j-marjanovic/theremin/PIC/ADC_ctrls.X/docs/README.txt

///////////////////////////////////////////////////////////////////////////////
//   __  __          _____      _         _   _  ______      _______ _____   //
//  |  \/  |   /\   |  __ \    | |  /\   | \ | |/ __ \ \    / /_   _/ ____|  //
//  | \  / |  /  \  | |__) |   | | /  \  |  \| | |  | \ \  / /  | || |       //
//  | |\/| | / /\ \ |  _  /_   | |/ /\ \ | . ` | |  | |\ \/ /   | || |       //
//  | |  | |/ ____ \| | \ \ |__| / ____ \| |\  | |__| | \  /   _| || |____   //
//  |_|  |_/_/    \_\_|  \_\____/_/    \_\_| \_|\____/   \/   |_____\_____|  //
//                                                                           //
//                          JAN MARJANOVIC, 2014                             //
//                                                                           //
///////////////////////////////////////////////////////////////////////////////

                            Analog inputs for FPGA

This Microchip PIC16F88 converts analog inputs and transmits data via UART
to FPGA.

UART is at 9600 bps.

Produced output:
MEAS:d5:a3:cf:02:33:00:f7:\r\n
