j-marjanovic/theremin/meas/antenna_2/theremin_freq_05cm.png

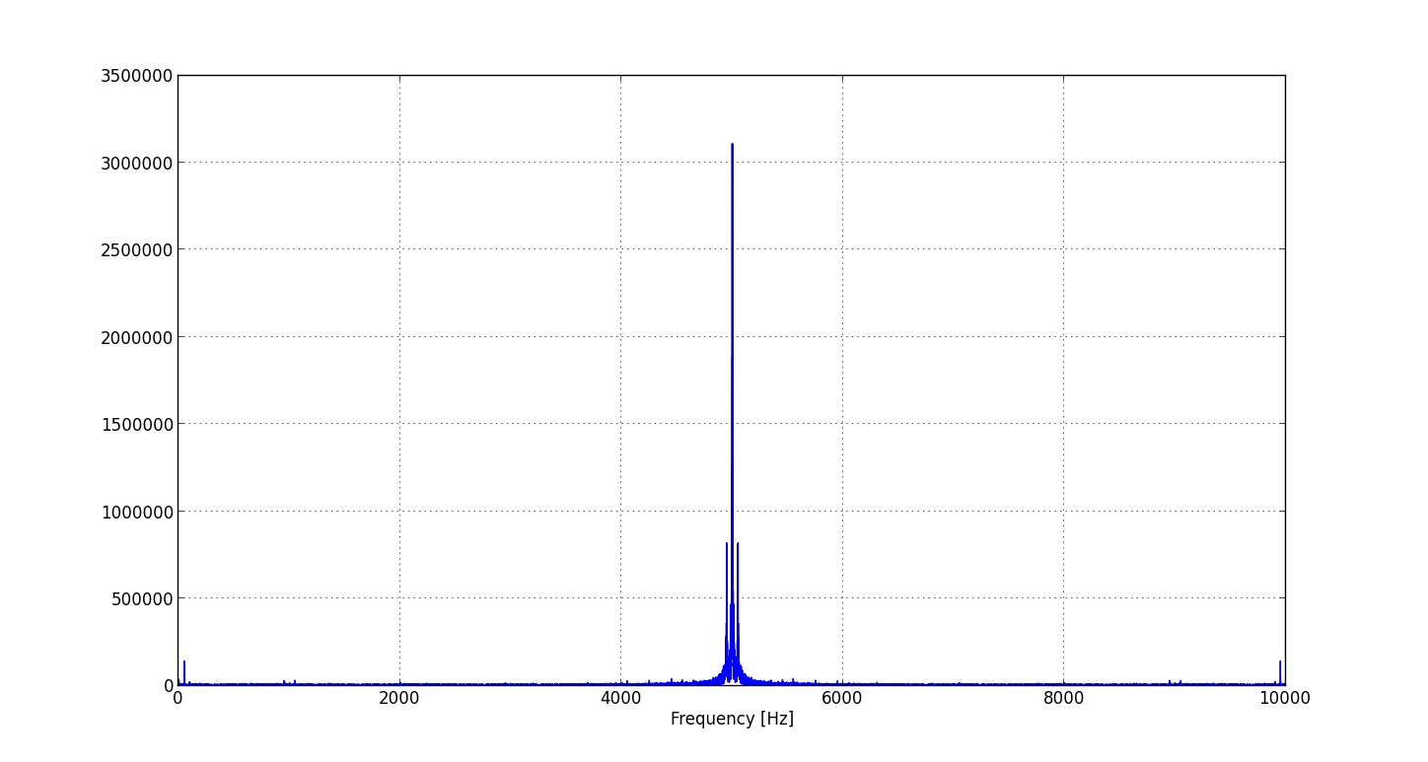
meas/antenna_2/theremin_freq_05cm.png
