j-marjanovic/theremin/meas/antenna_2/theremin_meas.png

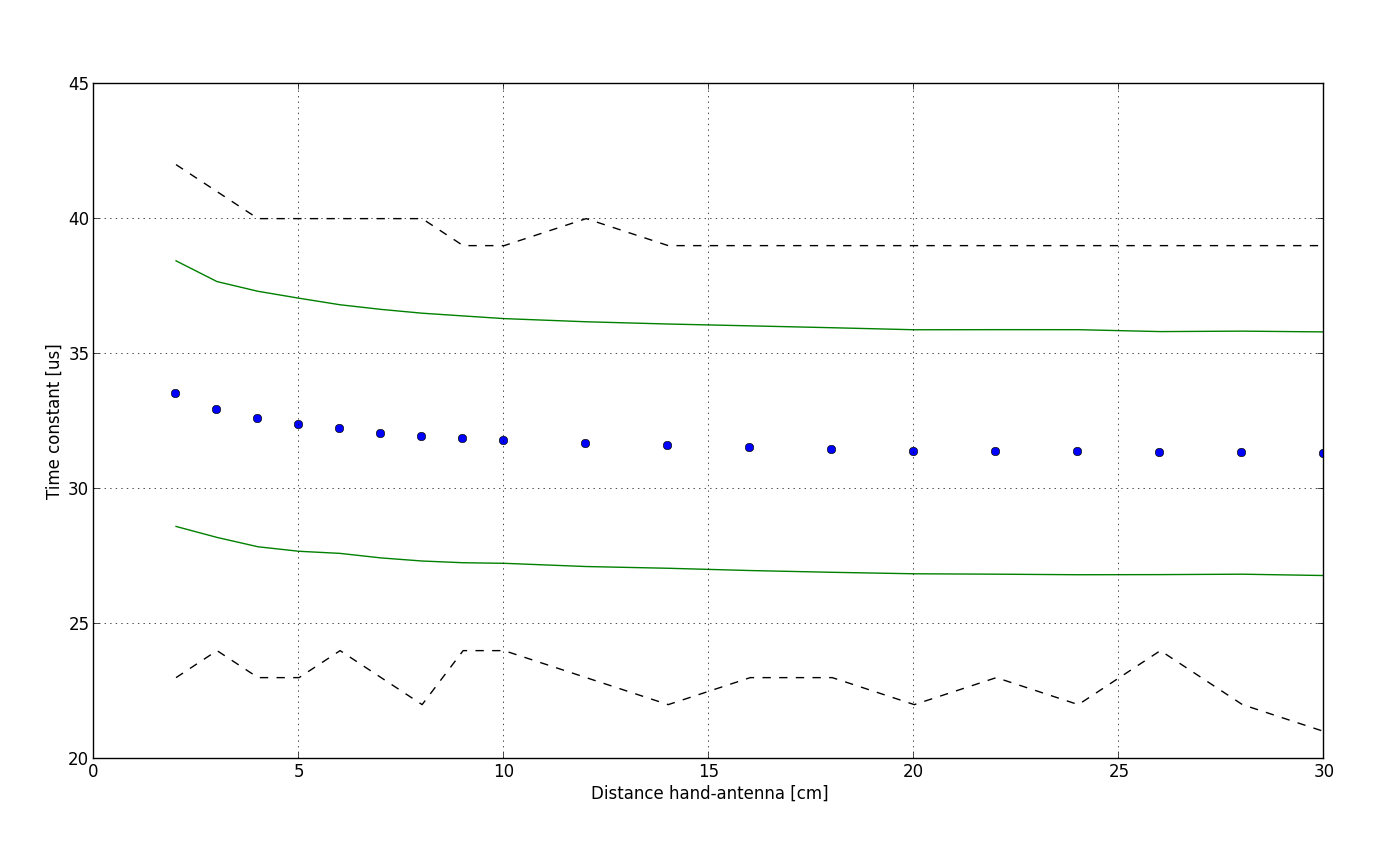
meas/antenna_2/theremin_meas.png
