j-marjanovic/theremin/meas/antenna_2/theremin_meas_mean.png

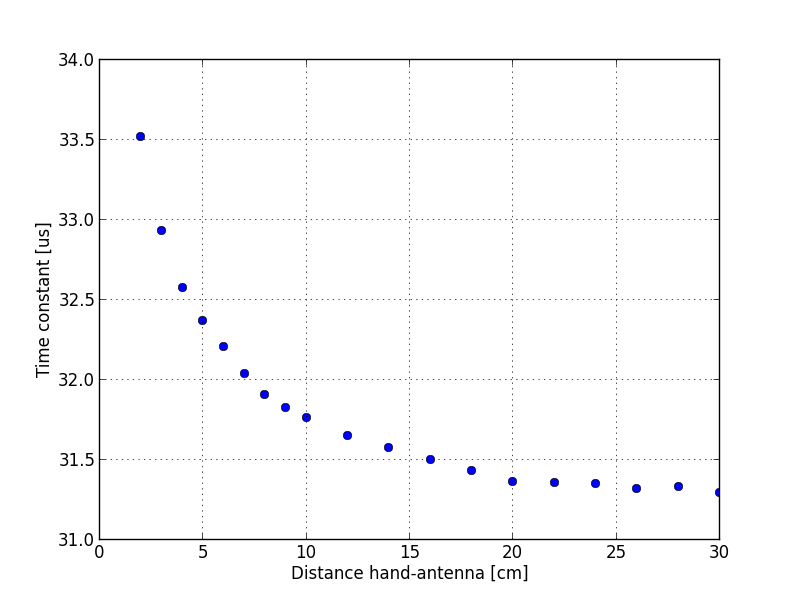
meas/antenna_2/theremin_meas_mean.png
