j-marjanovic/theremin/meas/filter_avg/tc_after_filter.png

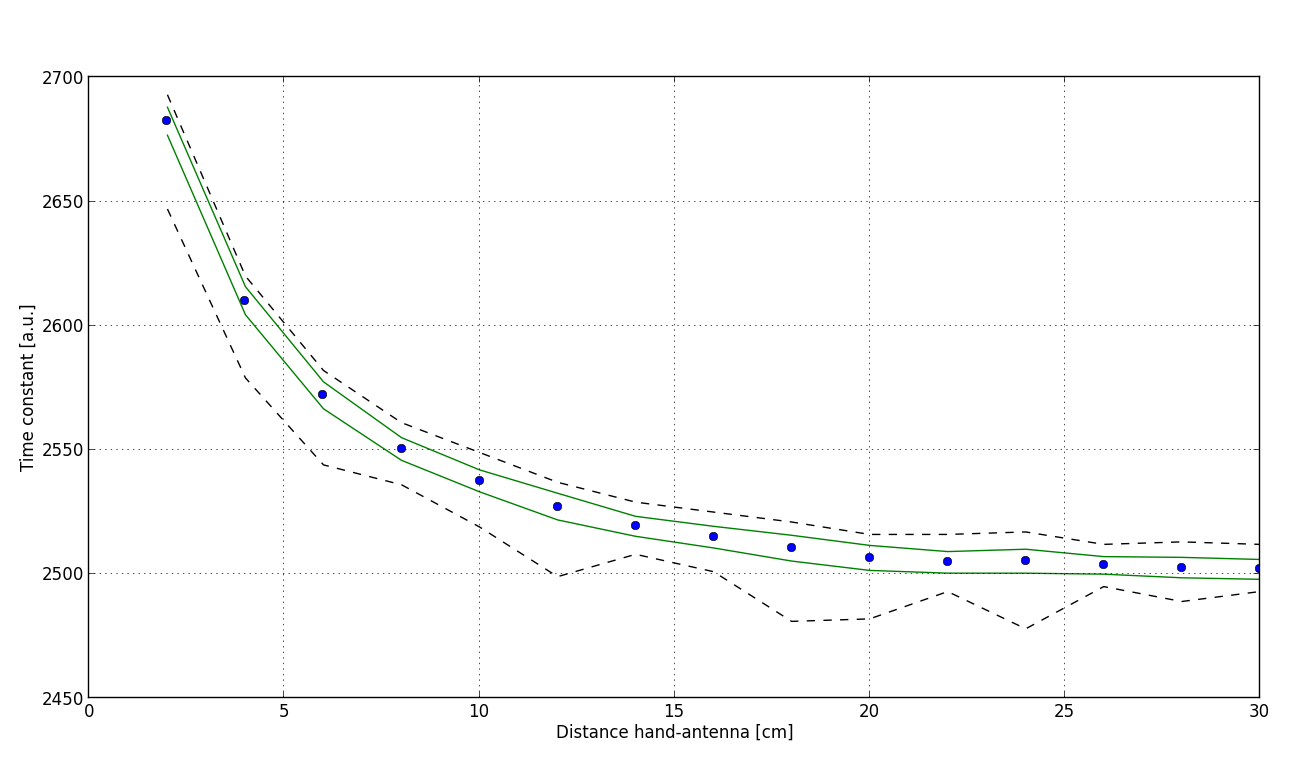
meas/filter_avg/tc_after_filter.png
