j-marjanovic/theremin/docs/components.txt

R8 = 10k
R9 = 10k
R10 = 10k
R13 = 100
R14 = 100

-10dBV = 0.316 volts AC
+4dBu = 1.23 volts AC

(R11 || R12)/R10 = 0.316V/3.3V = 0.09575

R11/R10 = 1.23V/3.3V = 0.372 --> R1 = 3.3k

R11 || R12 = 957

alternativa: 
R10 = 47k
R11 = 0.372*R10 = 18k
R11 || R12 = 4.5k
R12 = 5.6k
