j-marjanovic/theremin/(list of files, cad)

Other CAD files:
FPGA/signal_taps/delay.stp
FPGA/signal_taps/PIC_CTRL_in.stp
FPGA/signal_taps/TC.stp
FPGA/signal_taps/antenna.stp
FPGA/signal_taps/DAC.stp
