j-marjanovic/theremin/schematics/theremin_PCB.brd

## EAGLE design schematics/theremin_PCB.brd (2014-09-25)

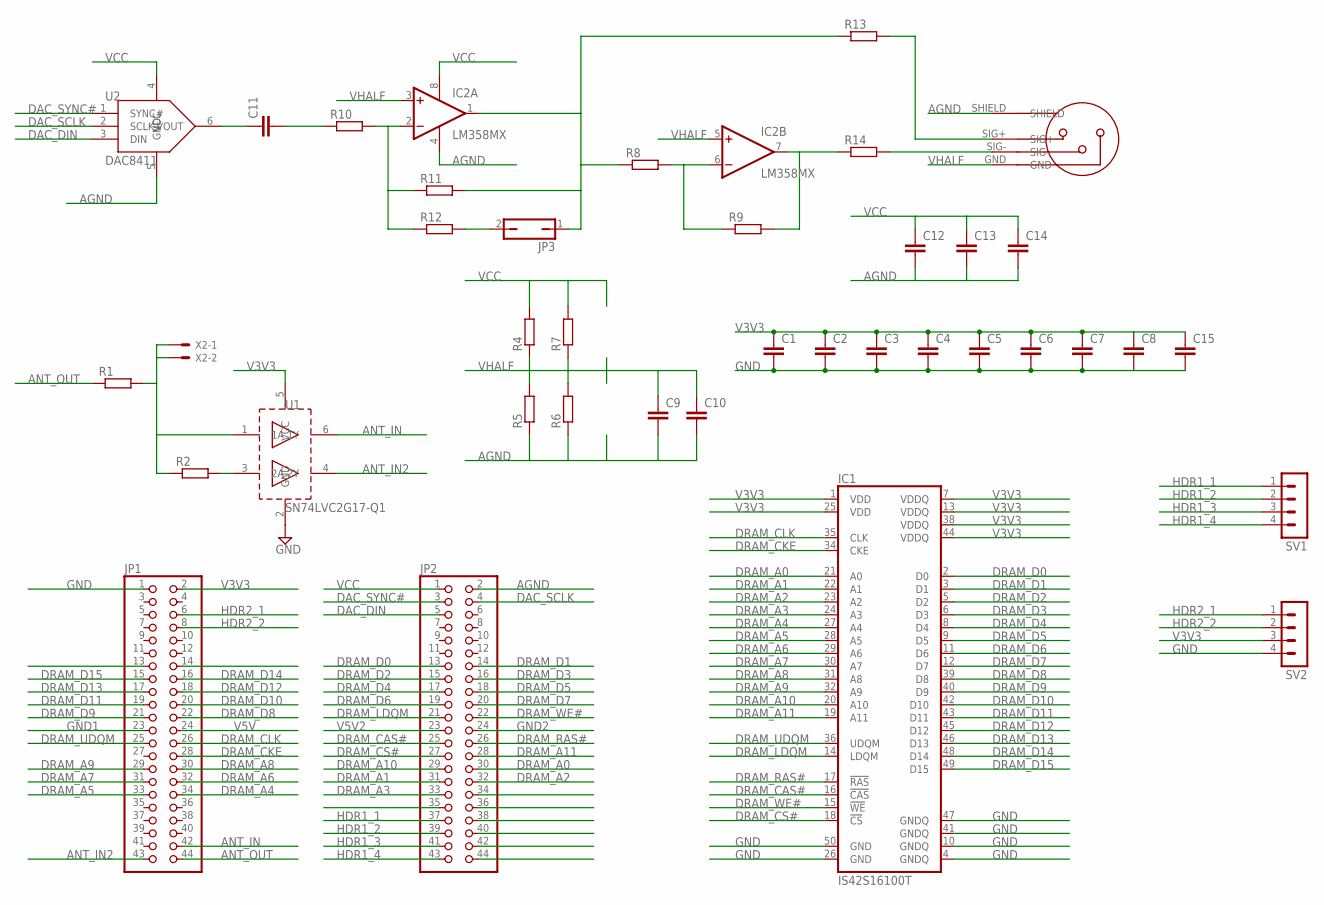
[picture p5: schematic theremin_PCB.sch]

Parts:
C1, C2, C3, C4, C5, C6, C7, C8, C9, C10, C11, C12, C13, C14, C15: C-EUC0805; C0805
IC1: IS42S16100T; TSOP50-II
IC2: LM358MX; SO08
JP1, JP2: PINHD-2X22; 2X22
JP3: JP1Q; JP1
R1, R2: R-EU_R0603; R0603
R4, R5, R6, R7, R8, R9, R10, R11, R12, R13, R14: R-EU_M0805; M0805
SV1, SV2: MA04-1
U1: SN74LVC2G17-Q1; DCK_R-PDSO-G6
U2: DAC8411; DCK_R-PDSO-G6
U$1: MINIXLR; MINXLR
X2: KK-156-2

Connections:
AGND: C9.2, C10.2, C12.2, C13.2, C14.2, IC2.4 (V-), JP2.2, R5.1, R6.1, U2.5 (GND), U$1.SHIELD
ANT_IN: JP1.42, U1.6 (1Y)
ANT_IN2: JP1.43, U1.4 (2Y)
ANT_OUT: JP1.44, R1.1
DAC_DIN: JP2.5, U2.3 (DIN)
DAC_SCLK: JP2.4, U2.2 (SCLK)
DAC_SYNC#: JP2.3, U2.1 (SYNC#)
DRAM_A0: IC1.21 (A0), JP2.30
DRAM_A1: IC1.22 (A1), JP2.31
DRAM_A2: IC1.23 (A2), JP2.32
DRAM_A3: IC1.24 (A3), JP2.33
DRAM_A4: IC1.27 (A4), JP1.34
DRAM_A5: IC1.28 (A5), JP1.33
DRAM_A6: IC1.29 (A6), JP1.32
DRAM_A7: IC1.30 (A7), JP1.31
DRAM_A8: IC1.31 (A8), JP1.30
DRAM_A9: IC1.32 (A9), JP1.29
DRAM_A10: IC1.20 (A10), JP2.29
DRAM_A11: IC1.19 (A11), JP2.28
DRAM_CAS#: IC1.16 (!CAS), JP2.25
DRAM_CKE: IC1.34 (CKE), JP1.28
DRAM_CLK: IC1.35 (CLK), JP1.26
DRAM_CS#: IC1.18 (!CS), JP2.27
DRAM_D0: IC1.2 (D0), JP2.13
DRAM_D1: IC1.3 (D1), JP2.14
DRAM_D2: IC1.5 (D2), JP2.15
DRAM_D3: IC1.6 (D3), JP2.16
DRAM_D4: IC1.8 (D4), JP2.17
DRAM_D5: IC1.9 (D5), JP2.18
DRAM_D6: IC1.11 (D6), JP2.19
DRAM_D7: IC1.12 (D7), JP2.20
DRAM_D8: IC1.39 (D8), JP1.22
DRAM_D9: IC1.40 (D9), JP1.21
DRAM_D10: IC1.42 (D10), JP1.20
DRAM_D11: IC1.43 (D11), JP1.19
DRAM_D12: IC1.45 (D12), JP1.18
DRAM_D13: IC1.46 (D13), JP1.17
DRAM_D14: IC1.48 (D14), JP1.16
DRAM_D15: IC1.49 (D15), JP1.15
DRAM_LDQM: IC1.14 (LDQM), JP2.21
DRAM_RAS#: IC1.17 (!RAS), JP2.26
DRAM_UDQM: IC1.36 (UDQM), JP1.25
DRAM_WE#: IC1.15 (!WE), JP2.22
GND: C1.2, C2.2, C3.2, C4.2, C5.2, C6.2, C7.2, C8.2, C15.2, IC1.4 (GNDQ), IC1.10 (GNDQ), IC1.26 (GND), IC1.41 (GNDQ), IC1.47 (GNDQ), IC1.50 (GND), JP1.1, SV2.4, U1.2 (GND)
GND1: JP1.23
GND2: JP2.24
HDR1_1: JP2.37, SV1.1
HDR1_2: JP2.39, SV1.2
HDR1_3: JP2.41, SV1.3
HDR1_4: JP2.43, SV1.4
HDR2_1: JP1.6, SV2.1
HDR2_2: JP1.8, SV2.2
unnamed: R1.2, R2.1, U1.1 (1A), X2.1, X2.2
unnamed: C11.1, U2.6 (VOUT)
unnamed: C11.2, R10.1
unnamed: R2.2, U1.3 (2A)
unnamed: IC2.2 (-IN), R10.2, R11.1, R12.1
unnamed: JP3.2, R12.2
unnamed: IC2.1 (OUT), JP3.1, R8.1, R11.2, R13.1
unnamed: R14.2, U$1.SIG-
unnamed: IC2.6 (-IN), R8.2, R9.1
unnamed: IC2.7 (OUT), R9.2, R14.1
unnamed: R13.2, U$1.SIG+
V3V3: C1.1, C2.1, C3.1, C4.1, C5.1, C6.1, C7.1, C8.1, C15.1, IC1.1 (VDD), IC1.7 (VDDQ), IC1.13 (VDDQ), IC1.25 (VDD), IC1.38 (VDDQ), IC1.44 (VDDQ), JP1.2, SV2.3, U1.5 (VCC)
V5V: JP1.24
V5V2: JP2.23
VCC: C12.1, C13.1, C14.1, IC2.8 (V+), JP2.1, R4.2, R7.2, U2.4 (VCC)
VHALF: C9.1, C10.1, IC2.3 (+IN), IC2.5 (+IN), R4.1, R5.2, R6.2, R7.1, U$1.GND

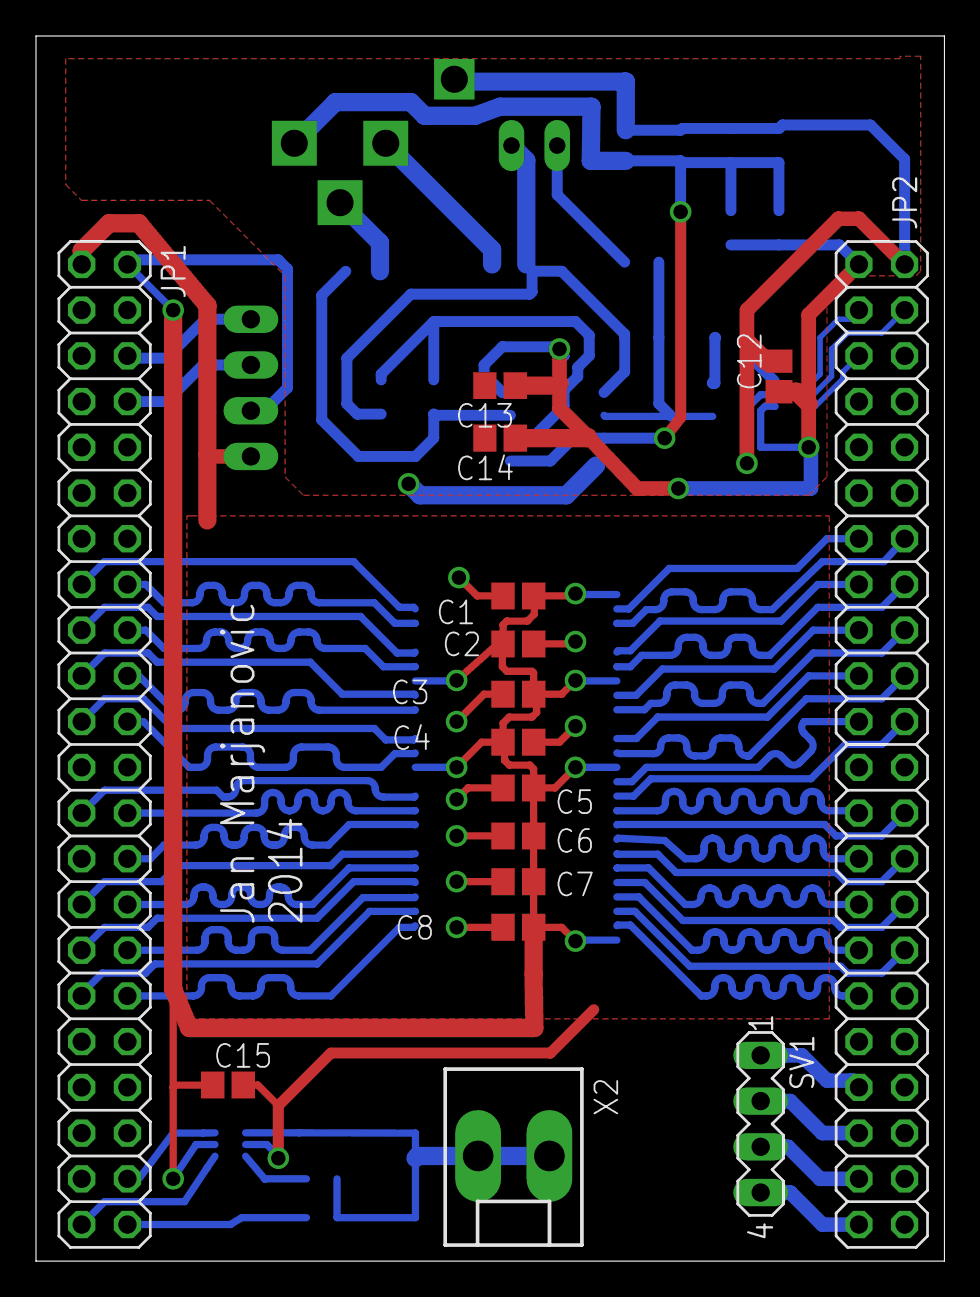
[picture p6: board theremin_PCB.brd from above]

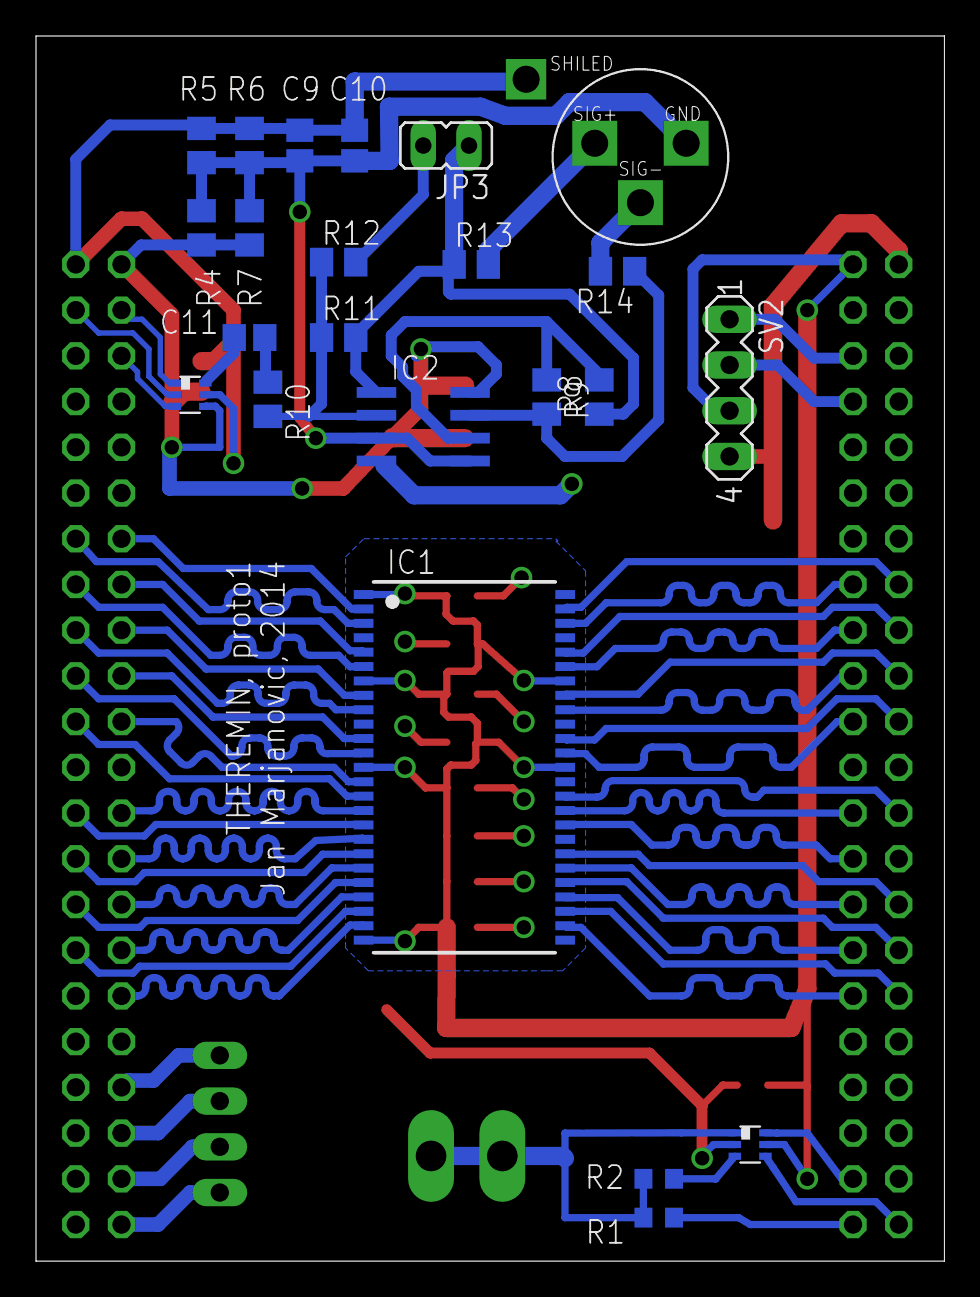
[picture p7: board theremin_PCB.brd from below]

Board: 2 copper layers, 50.5 x 68.1 mm, 39 parts (23 on the bottom side), 64 nets.
