j-marjanovic/theremin/PIC/ADC_ctrls.X/main.c

/******************************************************************************/
/* Files to Include                                                           */
/******************************************************************************/

#if defined(__XC)
    #include <xc.h>         /* XC8 General Include File */
#elif defined(HI_TECH_C)
    #include <htc.h>        /* HiTech General Include File */
#endif

#include <stdint.h>        /* For uint8_t definition */
#include <stdbool.h>       /* For true/false definition */

#include "system.h"        /* System funct/params, like osc/peripheral config */
#include "user.h"          /* User funct/params, such as InitApp */

/******************************************************************************/
/* User Global Variable Declaration                                           */
/******************************************************************************/

uint8_t ADCvalue[ADC_CHNS];
char str[64];


/******************************************************************************/
/* Main Program                                                               */
/******************************************************************************/
void main(void)
{
    /* Configure the oscillator for the device */
    ConfigureOscillator();

    /* Initialize I/O and Peripherals for application */
    InitApp();



    while(1)
    {
        doMeas(ADCvalue);
        createMeasString(str, ADCvalue);
        UART_Send_String(str);

        __delay_ms(1); //Delay
    }

}
