j-marjanovic/theremin/filter_50Hz/signal.h

signal[0] = 16'd3559;
signal[1] = 16'd2803;
signal[2] = 16'd3721;
signal[3] = 16'd2935;
signal[4] = 16'd3635;
signal[5] = 16'd2886;
signal[6] = 16'd3145;
signal[7] = 16'd2696;
signal[8] = 16'd3327;
signal[9] = 16'd2769;
signal[10] = 16'd3669;
signal[11] = 16'd2882;
signal[12] = 16'd3734;
signal[13] = 16'd2867;
signal[14] = 16'd3739;
signal[15] = 16'd2883;
signal[16] = 16'd3724;
signal[17] = 16'd2840;
signal[18] = 16'd3716;
signal[19] = 16'd2820;
signal[20] = 16'd3779;
signal[21] = 16'd2830;
signal[22] = 16'd3809;
signal[23] = 16'd2815;
signal[24] = 16'd3842;
signal[25] = 16'd2771;
signal[26] = 16'd3848;
signal[27] = 16'd2736;
signal[28] = 16'd3767;
signal[29] = 16'd2648;
signal[30] = 16'd3899;
signal[31] = 16'd2740;
signal[32] = 16'd3894;
signal[33] = 16'd2755;
signal[34] = 16'd3906;
signal[35] = 16'd2741;
signal[36] = 16'd3887;
signal[37] = 16'd2732;
signal[38] = 16'd3921;
signal[39] = 16'd2677;
signal[40] = 16'd3950;
signal[41] = 16'd2706;
signal[42] = 16'd3971;
signal[43] = 16'd2662;
signal[44] = 16'd3957;
signal[45] = 16'd2704;
signal[46] = 16'd3899;
signal[47] = 16'd2632;
signal[48] = 16'd3975;
signal[49] = 16'd2656;
signal[50] = 16'd3984;
signal[51] = 16'd2670;
signal[52] = 16'd3985;
signal[53] = 16'd2654;
signal[54] = 16'd3979;
signal[55] = 16'd2674;
signal[56] = 16'd3974;
signal[57] = 16'd2674;
signal[58] = 16'd3965;
signal[59] = 16'd2672;
signal[60] = 16'd3942;
signal[61] = 16'd2624;
signal[62] = 16'd3972;
signal[63] = 16'd2691;
signal[64] = 16'd4002;
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
signal[4832] = 16'd2682;
signal[4833] = 16'd3960;
signal[4834] = 16'd2714;
signal[4835] = 16'd3999;
signal[4836] = 16'd2641;
signal[4837] = 16'd3992;
signal[4838] = 16'd2640;
signal[4839] = 16'd4000;
signal[4840] = 16'd2615;
signal[4841] = 16'd4002;
signal[4842] = 16'd2686;
signal[4843] = 16'd4002;
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
