j-marjanovic/theremin/FPGA/src/LUT_sin.sv

initial begin
    LUT_sin[0] = 16'd32768;
    LUT_sin[1] = 16'd33170;
    LUT_sin[2] = 16'd33572;
    LUT_sin[3] = 16'd33974;
    LUT_sin[4] = 16'd34375;
    LUT_sin[5] = 16'd34777;
    LUT_sin[6] = 16'd35178;
    LUT_sin[7] = 16'd35579;
    LUT_sin[8] = 16'd35979;
    LUT_sin[9] = 16'd36379;
    LUT_sin[10] = 16'd36779;
    LUT_sin[11] = 16'd37177;
    LUT_sin[12] = 16'd37575;
    LUT_sin[13] = 16'd37973;
    LUT_sin[14] = 16'd38369;
    LUT_sin[15] = 16'd38765;
    LUT_sin[16] = 16'd39160;
    LUT_sin[17] = 16'd39554;
    LUT_sin[18] = 16'd39947;
    LUT_sin[19] = 16'd40339;
    LUT_sin[20] = 16'd40729;
    LUT_sin[21] = 16'd41119;
    LUT_sin[22] = 16'd41507;
    LUT_sin[23] = 16'd41894;
    LUT_sin[24] = 16'd42279;
    LUT_sin[25] = 16'd42663;
    LUT_sin[26] = 16'd43046;
    LUT_sin[27] = 16'd43427;
    LUT_sin[28] = 16'd43806;
    LUT_sin[29] = 16'd44184;
    LUT_sin[30] = 16'd44560;
    LUT_sin[31] = 16'd44934;
    LUT_sin[32] = 16'd45307;
    LUT_sin[33] = 16'd45677;
    LUT_sin[34] = 16'd46046;
    LUT_sin[35] = 16'd46413;
    LUT_sin[36] = 16'd46777;
    LUT_sin[37] = 16'd47140;
    LUT_sin[38] = 16'd47500;
    LUT_sin[39] = 16'd47858;
    LUT_sin[40] = 16'd48214;
    LUT_sin[41] = 16'd48567;
    LUT_sin[42] = 16'd48918;
    LUT_sin[43] = 16'd49267;
    LUT_sin[44] = 16'd49613;
    LUT_sin[45] = 16'd49957;
    LUT_sin[46] = 16'd50298;
    LUT_sin[47] = 16'd50636;
    LUT_sin[48] = 16'd50972;
    LUT_sin[49] = 16'd51305;
    LUT_sin[50] = 16'd51635;
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
    LUT_sin[499] = 16'd27562;
    LUT_sin[500] = 16'd27960;
    LUT_sin[501] = 16'd28358;
    LUT_sin[502] = 16'd28756;
    LUT_sin[503] = 16'd29156;
    LUT_sin[504] = 16'd29556;
    LUT_sin[505] = 16'd29956;
    LUT_sin[506] = 16'd30357;
    LUT_sin[507] = 16'd30758;
    LUT_sin[508] = 16'd31160;
    LUT_sin[509] = 16'd31561;
    LUT_sin[510] = 16'd31963;
    LUT_sin[511] = 16'd32365;
end	
