j-marjanovic/theremin/PIC/ADC_ctrls.X/configuration_bits.c

/******************************************************************************/
/* Main Files to Include                                                      */
/******************************************************************************/

#if defined(__XC)
    #include <xc.h>         /* XC8 General Include File */
#elif defined(HI_TECH_C)
    #include <htc.h>        /* HiTech General Include File */
#endif

/******************************************************************************/
/* Configuration Bits                                                         */
/*                                                                            */
/* Refer to your Hi-Tech User Manual in the PICC installation directory       */
/* /doc folder for more information on filling in configuration bits.         */
/* In addition, configuration bit mnemonics can be found in your              */
/* PICC\version\include\<processor name>.h file for your device.  The XC8     */
/* compiler contains documentation on the configuration bit macros within     */
/* the compiler installation /docs folder in a file called                    */
/* pic18_chipinfo.html.                                                       */
/*                                                                            */
/* For additional information about what the hardware configurations mean in  */
/* terms of device operation, refer to the device datasheet.                  */
/*                                                                            */
/* A feature of MPLAB X is the 'Generate Source Code to Output' utility in    */
/* the Configuration Bits window.  Under Window > PIC Memory Views >          */
/* Configuration Bits, a user controllable configuration bits window is       */
/* available to Generate Configuration Bits source code which the user can    */
/* paste into this project.                                                   */
/*                                                                            */
/******************************************************************************/

// CONFIG1
#pragma config FOSC = INTOSCIO  // Oscillator Selection bits (INTRC oscillator; port I/O function on both RA6/OSC2/CLKO pin and RA7/OSC1/CLKI pin)
#pragma config WDTE = OFF       // Watchdog Timer Enable bit (WDT disabled)
#pragma config PWRTE = ON       // Power-up Timer Enable bit (PWRT enabled)
#pragma config MCLRE = ON       // RA5/MCLR/VPP Pin Function Select bit (RA5/MCLR/VPP pin function is MCLR)
#pragma config BOREN = OFF       // Brown-out Reset Enable bit (BOR enabled)
#pragma config LVP = OFF         // Low-Voltage Programming Enable bit (RB3/PGM pin has PGM function, Low-Voltage Programming enabled)
#pragma config CPD = OFF        // Data EE Memory Code Protection bit (Code protection off)
#pragma config WRT = OFF        // Flash Program Memory Write Enable bits (Write protection off)
#pragma config CCPMX = RB0      // CCP1 Pin Selection bit (CCP1 function on RB0)
#pragma config CP = OFF         // Flash Program Memory Code Protection bit (Code protection off)

// CONFIG2
#pragma config FCMEN = ON       // Fail-Safe Clock Monitor Enable bit (Fail-Safe Clock Monitor enabled)
#pragma config IESO = ON        // Internal External Switchover bit (Internal External Switchover mode enabled
