j-marjanovic/theremin/FPGA/src/a_ctrls/baud_gen.v

//---------------------------------------------------------------------------------------
// baud rate generator for uart 
//
// this module has been changed to receive the baud rate dividing counter from registers.
// the two registers should be calculated as follows:
// first register:
// 		baud_freq = 16*baud_rate / gcd(global_clock_freq, 16*baud_rate)
// second register:
// 		baud_limit = (global_clock_freq / gcd(global_clock_freq, 16*baud_rate)) - baud_freq 
//
//---------------------------------------------------------------------------------------

module baud_gen # (
	parameter fCLK		= 50_000_000,
	parameter fBAUD		= 9_600
)(
	clock, 
	reset, 
	ce_16
);
//---------------------------------------------------------------------------------------
// modules inputs and outputs 
input 			clock;		// global clock input 
input 			reset;		// global reset input 
output			ce_16;		// baud rate multiplyed by 16 
localparam baud_limit = fCLK / (16*fBAUD);

// internal registers 
reg ce_16;
reg [15:0]	counter;
//---------------------------------------------------------------------------------------
// module implementation 
// baud divider counter  
always @ (posedge clock or posedge reset)
begin
	if (reset) 
		counter <= 16'b0;
	else if (counter >= baud_limit) 
		counter <= 0;
	else 
		counter <= counter + 1;
end

// clock divider output 
always @ (posedge clock or posedge reset)
begin
	if (reset)
		ce_16 <= 1'b0;
	else if (counter >= baud_limit) 
		ce_16 <= 1'b1;
	else 
		ce_16 <= 1'b0;
end 

endmodule
//---------------------------------------------------------------------------------------
//						Th.. Th.. Th.. Thats all folks !!!
//---------------------------------------------------------------------------------------
