j-marjanovic/theremin/(commit log)

2014-09-14 UART and ADC bringup
2014-09-14 - Moved UART to system.c - Added createMeasString function
2014-09-14 - Moved ADC part to system.c - Added doMeas function to measure ADCs
2014-09-25 Added schematics
    [theremin_PCB.brd, theremin_PCB.sch]
2014-09-27 DAC tested
    [DAC.stp]
2014-09-28 UART core from OpenCores UART to Bus
2014-10-11 Implemeted delay
    [delay.stp]
2014-10-11 Changed maximum possible value for delay
    [delay.stp]
2014-10-23 Filter works, code generation from python not yet
2014-10-26 Filter generation works
2014-10-26 Added delay to step, to better show response for high-pass filters
2014-10-31 Measurements with new antenna
2014-10-31 Added averaging filter
    [PIC_CTRL_in.stp, TC.stp, antenna.stp, filter_antilog.stp]
2014-10-31 Added logarithm for better response
    [filter_antilog.stp]
2014-11-03 Improved logarithm module
    [filter_antilog.stp]
2014-11-08 Delay works OK
    [delay.stp]
2014-11-13 Added LEDs logic
